danielvl1982/Dactyl-ZMK-Config/docs/preguntas-abiertas.md

# Preguntas abiertas

Points that cannot be confirmed from the code alone, and inconsistencies found while documenting. They stay marked as "inferred from code" in the rest of the documentation until answered. Global, stable numbering: items are never renumbered; resolved ones are struck through and kept.

## Negocio y datos

3. **Behavior with several layer keys held is not defined** (`config/dactyl.keymap:15-17`, `config/dactyl.keymap:44`, `config/dactyl.keymap:48`, `config/dactyl.keymap:50`, `config/dactyl.keymap:71`, `config/dactyl.keymap:84`). Holding two layer keys (for example SYM and NAV) activates both with the higher index winning; is that acceptable, or should a conditional layer or exclusive rule be defined? Impact: accidental double holds (pinky on SYM or NAV plus thumb on FN) can type characters from an unintended layer; for example SYM wins at the BT_SEL positions 31-33 when SYM and NAV are held, so profile select does nothing (BT_CLR still works).
4. **Rare ES AltGr symbols (euro and others) are not on SYM** (`docs/03-keymap.md:221-222`, `config/dactyl.keymap:77-88`). Should the euro sign and other AltGr symbols be added to SYM, and is a physical AltGr key needed? Impact: those characters cannot be typed from this keymap.
5. **BLE bond persistence is assumed from ZMK defaults** (`config/dactyl.keymap:71`, `config/dactyl.conf:1-15`, `build.yaml:6-8`). Confirm that bonds and the active profile survive power cycles and deep sleep on the nice!nano (no settings option is set in this repo). Impact: if settings are not persisted, the profile keys and the `settings_reset` image behave differently from what the docs describe.
6. **BT_CLR scope (central only) is not provable from this repo** (`config/dactyl.keymap:71`, `docs/03-keymap.md:140-141`). Does BT_CLR on the left (central) also clear the peripheral bond, or must `settings_reset` be flashed on the right half too? Impact: stale right-half bonds may remain after BT_CLR.
7. **Order to reset, re-flash and pair both halves with the host is undocumented** (`docs/operaciones.md:47`, `docs/04-roadmap.md:47-49`, `README.md:64-65`, `build.yaml:6-8`). In which order should `settings_reset` and the real firmware be flashed on each half, and must the host forget the keyboard before re-pairing? Owner to confirm after the first hardware run. Impact: a wrong order may leave stale bonds on a half or on the host and break pairing; the procedure is prose only and untested.
8. **Host view when the right half is asleep, off or out of range** (`config/dactyl.conf:3-6`, `config/dactyl.conf:11-12`). What level does the host show for the right half when it is disconnected or in deep sleep (stale value, zero, or entry removed)? Impact: the user may read an old level and not notice a drained right cell; no cut-off protects the cell.
9. **Origin of `holeD` 6.1 mm and `capH` 16 mm** (`hardware/switch-button/switch_cap.mjs:52`, `hardware/switch-button/switch_cap.mjs:55`, `hardware/switch-button/switch_cap.mjs:57`, `hardware/third-party/dactyl-4x6-trackball/pro_micro_adapter.stl`). `holeD` is marked MEASURED from `pro_micro_adapter.stl` and `capH` is marked MEASURE; who measured them and are they confirmed on a printed case? Does `stemH` 8.0 mm match the stated "1.9 wall + 4 out"? Impact: wrong values give a cap that does not pass through the hole or does not stand out of the case.

## Técnicas

10. **ZMK `revision: main` and CI `@main` are unpinned** (`config/west.yml:6-8`, `.github/workflows/build.yml:6`, `build.yaml:6-8`). Should the ZMK revision and the reusable workflow ref be pinned together to a tag or commit? Priority: low. Explanation for the owner: pinning fixes a version so builds are reproducible; without it any upstream change on ZMK `main` (including the `settings_reset` image and role/name defaults) can break or alter the firmware without a commit in this repo. Pinning to an old release may not compile because the shield uses the `nice_nano//zmk` board syntax; the minimum revision that supports it is unknown. User answer (user, docs-orchestrator session, October 2026): did not know the term and said "if it is a problem, fix it"; left OPEN, not decided. Impact: non-reproducible builds, silent breakage.
11. **Firmware v1.0 is not verified on hardware** (`docs/02-current-state.md:15`, `docs/02-current-state.md:55`, `docs/05-build-log.md:15`, `docs/05-build-log.md:20`, `docs/04-roadmap.md:24`, `docs/04-roadmap.md:41-50`, `docs/04-roadmap.md:57-58`, `config/boards/shields/dactyl/dactyl.dtsi:36-41`). Confirm on both flashed halves: the CI `.uf2` files work, the final 12-column transform and position table (F8), momentary SYM/NAV/NUM layers with `&trans` fall-through, NAV, BT_SEL 0..2 and BT_CLR including re-pairing, battery levels on the host (and on Windows with enforcement off), deep sleep and key wake with BLE reconnection, and the flash/reset/pair flow. Owner of the keyboard. Impact: a green build proves only that the firmware compiles; documented behavior is inferred from the keymap and ZMK semantics.
12. **ES host layout is assumed but cannot be enforced or detected** (`config/dactyl.keymap:8-10`, `config/dactyl.keymap:28`, `config/dactyl.keymap:34`, `config/dactyl.keymap:46`, `config/dactyl.keymap:50`, `config/dactyl.keymap:57`, `docs/03-keymap.md:3`, `docs/03-keymap.md:189-192`). Is ES (Windows KBDSP) the only supported host layout, including when switching Bluetooth profiles between machines (F7), or will X11 `es` or macOS layouts be used too? Impact: on a non-ES host, ñ, dead acute, hyphen, `{`, `}`, `[`, `]`, `\`, `<`, `>`, GRAVE (º) and the dead-key macros type different characters (for example the macros type "[ " and "{ ").
13. **Layer keys are on the peripheral half** (`config/dactyl.keymap:44`, `config/dactyl.keymap:48`, `config/dactyl.keymap:50`, `config/dactyl.conf:9-12`). What happens to layer state if the right half disconnects while a layer key is held (stuck layer)? Is it tested? Impact: a BLE drop mid-hold could leave a layer active or lose the release event.
14. **Consumer HID keys (volume, media) rely on a ZMK default** (`config/dactyl.keymap:71`, `config/dactyl.keymap:73`, `config/dactyl.conf:1-15`). Is the default consumer report enough on every target host (PC, laptop, phone)? Impact: volume and media keys may not work on a host that ignores consumer usages.
15. **PLAY replaces SPACE and letter keys are shadowed while NAV is held** (`config/dactyl.keymap:73`, `config/dactyl.keymap:50`). Is losing the space bar in NAV intended, given the board has no thumb cluster? Impact: media control and typing space cannot be combined in one hold.
16. **Last key of NUM row 1 is transparent and falls to the base-layer SYM key** (`config/dactyl.keymap:57`, `config/dactyl.keymap:44`). Is it intended that this position acts as `&mo LAYER_SYM` while FN is held, or should it be `&none`? Impact: holding FN and pressing that key activates SYM on top of NUM, which may be accidental.
17. **Physical Shift held on SYM changes plain-keycode symbols** (`config/dactyl.keymap:48`, `config/dactyl.keymap:80`, `config/dactyl.keymap:82`, `config/dactyl.keymap:84`). Should LSHFT be `&none` on SYM, or is shifted output (for example `<` becoming `>`) acceptable? Needs a flash test. Impact: holding Shift while typing symbols may yield a different character (inferred from code, unverified).
18. **Trackball (Logitech M575) is undecided and unsupported in code** (`README.md:19`, `docs/01-hardware.md:7`, `docs/04-roadmap.md:63`, `docs/04-roadmap.md:81`, `config/boards/shields/dactyl/dactyl_right.overlay:1-18`, `config/boards/shields/dactyl/dactyl.zmk.yml:8-9`). No sensor node, driver or ZMK pointing-device feature exists (roadmap says "Not started"), yet README and hardware docs describe a trackball on the right half. User context (user, docs-orchestrator session, October 2026): the owner has a Logitech M575 and has not decided whether to integrate it into the keyboard or keep it separate; integrating would need an extra board, or embedding the M575 board with its own power; the battery impact is unknown; the owner thinks there is enough space with small modifications. Which integration is intended (ZMK pointing device, embedded M575 board, or separate device), and should the docs say "planned/undecided"? Impact: the trackball cannot work with the current firmware; docs promise hardware the firmware does not drive.
19. **Upstream defaults of ZMK/Zephyr keys are assumed, not proven** (`config/dactyl.conf:3-6`, `config/dactyl.conf:10-12`, `config/dactyl.conf:14-15`, `config/west.yml:6-7`, `config/dactyl.keymap:71`). Confirm against the ZMK revision CI builds the defaults of `CONFIG_ZMK_SLEEP`, `CONFIG_ZMK_IDLE_SLEEP_TIMEOUT` (900000 ms and ms unit), `CONFIG_ZMK_BATTERY_REPORTING`, the two split battery fetching/proxy keys, `CONFIG_BT_GATT_ENFORCE_SUBSCRIPTION`, and the maximum BLE profile count (is the default at least 3, or should it be set explicitly?). Impact: the Default column of the keys table is inferred; if a default changes upstream, explicit values still win but the reason for each line cannot be checked, and a BT_SEL key would do nothing if the profile count were below 3.
20. **Peripheral role is implicit, relies on ZMK defaults** (`config/boards/shields/dactyl/Kconfig.defconfig:6-7`, `config/boards/shields/dactyl/Kconfig.defconfig:13-14`). Should the right half set an explicit peripheral option, or is relying on the ZMK default (split on, central off) intended? Impact: a ZMK change to the default could silently change the right-half role.
21. **Erase behavior of `settings_reset` is upstream and unverifiable here** (`build.yaml:6-8`). Does the ZMK `settings_reset` shield wipe the whole settings partition (bonds and profiles) at the unpinned `main` revision, as the comment states? Owner to confirm. Impact: if upstream changes the shield, the documented wipe may no longer hold.
22. **Artifact names, upload and retention of the CI build are defined upstream** (`.github/workflows/build.yml:6`, `README.md:59-61`, `docs/05-build-log.md:107-108`). What are the artifact names the reusable ZMK workflow produces, how long are they kept, so the right `.uf2` is copied to each half? Impact: risk of copying the wrong image; documented outputs rest on the build log, not on code in this repo.
23. **Central-only battery keys set in a conf shared with the peripheral** (`config/dactyl.conf:1`, `config/dactyl.conf:11-12`, `config/boards/shields/dactyl/Kconfig.defconfig:6-7`). Are the FETCHING and PROXY keys harmlessly ignored on the right half, or should they live in a left-only conf? Impact: an unused or unsupported symbol could cause a build warning or wasted code on the peripheral.
24. **Macro timing uses ZMK defaults and is not configured** (`config/dactyl.keymap:25-35`, `config/dactyl.conf`). Have the macros been tested on hardware and BLE hosts, or are `wait-ms`/`tap-ms` needed so the host registers the dead key before the space? Impact: on a slow host the space could arrive too early and the literal character might not compose.
25. **No automated tests; validation is compile plus manual typing** (`build.yaml:1-8`, `docs/04-roadmap.md:24`). Is flashing the CI artifacts and typing the only intended validation? CodeGraph indexes only `.mjs` files, so devicetree/Kconfig/keymap were read directly. Impact: regressions in the keymap or shield are found only on hardware.
26. **No deployment or release process** (`.github/workflows/build.yml:1-6`). Are releases or tagged artifacts wanted, or is manual download from workflow runs enough? Impact: firmware versions cannot be traced to a flashed board.
27. **Behavior of swapped or same-side firmware is not verified** (`config/boards/shields/dactyl/dactyl_right.overlay:15-18`, `config/boards/shields/dactyl/dactyl_left.overlay:3-13`). What happens if the left image is flashed on the right half or the reverse? Has it been tested? Impact: a wrong flash could give duplicated or missing columns; troubleshooting steps are unknown.
28. **Which half executes the `&bt` behavior when pressed on the right (peripheral) half** (`config/dactyl.keymap:71`, `config/boards/shields/dactyl/Kconfig.defconfig:6-7`, `docs/03-keymap.md:141-142`). Does BT_SEL/BT_CLR pressed on the right half act on the left central (as the docs claim) and change the host-facing profile? Needs confirmation on hardware. Impact: if the event were handled on the peripheral, profile switching would not affect the host connection.
29. **Generators have no validation and ignore their own fit checks** (`hardware/switch-button/switch_cap.mjs:135-150`, `hardware/switch-button/switch_cap.mjs:186-187`, `hardware/18650-holder/holder_18650_tight.mjs:40-84`, `hardware/18650-holder/holder_18650_tight.mjs:212-225`, `hardware/18650-holder/holder_18650_tight.mjs:264`). `switch_cap.mjs` prints FIT PROBLEMS but still overwrites the STL and exits 0; the holder generator has no parameter or non-manifold check at all. Should they skip the write or exit non-zero on problems (owner of the hardware decides)? Impact: a bad parameter set silently replaces the tracked STL with a part the script itself flagged, and `npm run build` still succeeds.
30. **`writeBinarySTL` is duplicated in both generators** (`hardware/18650-holder/holder_18650_tight.mjs:230-255`, `hardware/switch-button/switch_cap.mjs:155-180`). Extract a shared module, or keep the copies so each folder stays self-contained with its own `package.json`? Impact: a fix to normals or header in one writer must be applied twice.
31. **Committed STLs are not verified against the generators** (`hardware/18650-holder/holder_18650_tight.stl`, `hardware/18650-holder/holder_18650_tight_mirrored.stl`, `hardware/switch-button/switch_cap.stl`, `hardware/18650-holder/package.json:7`, `hardware/switch-button/package.json:7`). Are the STLs regenerated after every change to `P` (the last commit changed the end discs), and should a check or CI step enforce it? Deterministic output is inferred, not tested. Impact: STLs and parameters can drift apart; printed parts may not match the script described as the source of truth.
32. **Node engine version is not declared for the generators** (`hardware/18650-holder/package.json:1-13`, `hardware/switch-button/package.json:1-13`). Which Node version is required (ESM and top-level await)? Impact: generators may fail on older Node without a clear message.
33. **`seatDepth` does not control the real pocket depth in `terminalSeat`** (`hardware/18650-holder/holder_18650_tight.mjs:95-99`, `hardware/18650-holder/holder_18650_tight.mjs:111`, `hardware/18650-holder/holder_18650_tight.mjs:128-130`). The pocket extent into the wall is `xFace -/+ EPS` (EPS = 1.0), while `seatDepth` only affects the bore-side edge and `innerSpan`; is this slip intended? It works only because both equal 1.0. Impact: changing `seatDepth` alone makes `innerSpan` inconsistent with the cut pocket depth (inferred from code).
34. **Cradle side cut executed twice** (`hardware/18650-holder/holder_18650_tight.mjs:171`, `hardware/18650-holder/holder_18650_tight.mjs:194`). Is the second identical subtract (after the bore) intentional or a leftover? Impact: redundant boolean operation, no geometric effect (inferred from code).

## Seguridad

35. **GATT subscription enforcement is disabled to show battery on Windows** (`config/dactyl.conf:14-15`). Is disabling `CONFIG_BT_GATT_ENFORCE_SUBSCRIPTION` an accepted trade-off for all hosts, and does the battery display still require it with the ZMK revision used? Impact: weakens a BLE GATT check on every connection, not only on Windows, for a cosmetic battery display.

## Inconsistencias

36. **Holder generator header describes flush-trimmed end walls while `roundEnds` is true** (`hardware/18650-holder/holder_18650_tight.mjs:8-26`, `hardware/18650-holder/holder_18650_tight.mjs:61`, `hardware/18650-holder/holder_18650_tight.mjs:92`, `hardware/18650-holder/holder_18650_tight.mjs:166`). The header describes end walls flush with the rim and overall height 10.75 mm; with `roundEnds: true` the trim and ears are skipped and the end discs rise to `outerR` (11.45), so the overall height is about 22.2 mm (derived by hand). Which is the intended design, does it still fit the case, and should the header be rewritten? Impact: anyone trusting the header expects a low-profile holder; the printed part is taller at the end discs.
37. **`P.tabLen` is defined but never read** (`hardware/18650-holder/holder_18650_tight.mjs:76`). Remove `tabLen` or wire it into the tab channel/groove geometry? Impact: editing the value has no effect and misleads whoever tunes the holder.
38. **Ear parameters are dead while `roundEnds` is true** (`hardware/18650-holder/holder_18650_tight.mjs:66-69`, `hardware/18650-holder/holder_18650_tight.mjs:166-188`). Is the flat-end/ear variant still supported, or is `roundEnds` the only design to keep? Impact: `earAbovePlate`, `earSide`, `earChamfer` and the flush-trim branch are unreachable with the committed settings and may rot untested.
39. **Lead-in step corner wall is not checked** (`hardware/switch-button/switch_cap.mjs:112-115`, `hardware/switch-button/switch_cap.mjs:136`). Is a corner wall of about 0.66 mm at the lead-in mouth (default parameters) acceptable for printing? The 0.8 mm minimum is applied only to the socket. Impact: the thin rim could break or print poorly while the report says `fit : ok`.
40. **README and docs mention a TRRS cable, a trackball and an old file layout that the code does not contain** (`README.md:19`, `README.md:40-52`, `docs/01-hardware.md:12`). The README layout lists `dactyl_left.keymap` and `shields/dactyl_left`, but the repo has `dactyl.keymap` and `shields/dactyl`. Update the README? (Trackball part: see 18.) Impact: docs contradict the repository structure.
41. **README says builds run on pushes that change the config, but the workflow has no path filter** (`README.md:61`, `.github/workflows/build.yml:2`). Limit the workflow to config changes, or correct the README? Impact: docs-only pushes consume CI minutes and produce artifacts; the README is inaccurate.
42. **README says one half is flashed, current-state says both halves were** (`README.md:7`, `docs/02-current-state.md:21`, `docs/05-build-log.md:189`). Which is current: one half or both flashed with the test keymap? Impact: contradictory statement of the hardware verification baseline.
43. **Docs say 15 letters per hand but the right half has 12 letters** (`docs/03-keymap.md:56`, `config/dactyl.keymap:44-48`). Should the geometry line say 15 letters on the left and 12 on the right (plus ñ), or was a different count intended? Impact: documentation misstates the base layer layout.
44. **Layer indexes rely on node order with no check** (`config/dactyl.keymap:12`, `config/dactyl.keymap:15-17`, `config/dactyl.keymap:41`, `config/dactyl.keymap:54`, `config/dactyl.keymap:64`, `config/dactyl.keymap:77`). Should the `LAYER_*` constants be guarded (comment, CI check) or is the file order considered stable? Impact: reordering layer nodes silently remaps every `&mo` key.
45. **Stale legend comment on NAV row 3 omits the Bluetooth keys** (`config/dactyl.keymap:70`, `config/dactyl.keymap:71`). Should the comment list BT 0, BT 1, BT 2 and BT CLR as the bindings do? Impact: a reader believes the right half of row 3 is blank except DEL.
46. **END is bound on both the base layer and NAV while docs say it stays on base** (`config/dactyl.keymap:50`, `config/dactyl.keymap:67`, `docs/03-keymap.md:93`, `docs/05-build-log.md:134`). Is END on NAV intentional (grouped with HOME, PGUP, PGDN) or should it be `&trans`? Impact: redundant binding; docs describe only HOME moving to NAV.
47. **Docs say blank NUM cells are transparent but the outer-bottom keys are `&none`** (`docs/03-keymap.md:121`, `config/dactyl.keymap:60`). Should the doc mention the `&none` positions, or should they be `&trans`? Impact: cells look identical in the diagram but behave differently (`&none` blocks fall-through).
48. **Docs say the right pinky and outer columns are unavailable under SYM, but they are `&trans`** (`docs/03-keymap.md:146-148`, `config/dactyl.keymap:80-86`, `config/dactyl.keymap:46`, `config/dactyl.keymap:50`). Is the fall-through to base (ñ, dead acute, ENTER, BSPC, MO(NUM), MO(NAV)) intended while SYM is held, or should those positions be `&none`? Impact: documentation misstates which keys work under SYM.
49. ~~**Wrong line cited for `CONFIG_ZMK_BATTERY_REPORTING` in operaciones.md**~~ Resuelto (October 2026): the citation in `docs/operaciones.md:67` was corrected from `config/dactyl.conf:9` to `config/dactyl.conf:10`, the line that holds the key (verified in `docs/operaciones.md:67` and `config/dactyl.conf:10`).
50. **Docs say "No macros" for accents while two dead-key macros exist** (`docs/03-keymap.md:19-20`, `docs/03-keymap.md:216-217`, `config/dactyl.keymap:25-35`). Should the accents note say only acute and diaeresis are native dead keys, and grave and caret use macros? Impact: documentation contradicts the keymap.
51. **Docs list dead grave as `&kp LBKT` but SYM binds `macro_grave`** (`docs/03-keymap.md:36`, `docs/03-keymap.md:197`, `config/dactyl.keymap:80`). Is there intentionally no plain dead grave key on any layer? Impact: grave-accented vowels (à, è, ò) cannot be typed because the macro always appends a space.
52. **`docs/02-current-state.md` describes a transform diagnosis that no longer matches the overlays** (`docs/02-current-state.md:40-50`, `config/boards/shields/dactyl/dactyl_left.overlay:3-13`, `config/boards/shields/dactyl/dactyl.dtsi:32-42`). Should it say the mirror fix is already applied in the shared transform (reversed right columns plus col-offset)? Impact: the doc says the fix is pending; the overlay now holds no transform.
53. **Keyboard name is defined twice** (`config/boards/shields/dactyl/Kconfig.defconfig:4`, `config/boards/shields/dactyl/dactyl.zmk.yml:3`). Is the metadata `name` only a UI label, and should both be kept in sync by hand? Impact: renaming in one place leaves the other stale; the BLE name comes only from the Kconfig value.

## Resuelto durante la documentación

1. ~~**Matrix transform maps 24 positions per half but each half has 23 keys**~~ Resuelto (October 2026): 23 physical keys per half is correct; the 24th transform position (RC(3,0) / RC(3,6), positions 36 and 47) is intentionally kept and bound to `&none`, so the keymap stays a regular 4x12 grid (user, docs-orchestrator session). Evidence: `config/boards/shields/dactyl/dactyl.dtsi:29-31`, `config/boards/shields/dactyl/dactyl.dtsi:37-40`, `config/dactyl.keymap:50`, `README.md:16`. Follow-up: README/docs wording is correct, no code change; the .dtsi comment may optionally say the position is kept on purpose.
2. ~~**Idle sleep timeout was set in the working tree but the committed file said default**~~ Resuelto (October 2026): the owner decided 5 minutes (the only cost of a shorter timeout versus 15 min is a slightly slower first keypress after wake) (user, docs-orchestrator session). `config/dactyl.conf:3-6` sets `CONFIG_ZMK_IDLE_SLEEP_TIMEOUT=300000`, committed in 8ac7234 (`feat(firmware): set deep sleep idle timeout to 5 minutes`, on main). Follow-up: `sueno-profundo`, `configuracion` and `operaciones` already say 5 min.
