danielvl1982/Dactyl-ZMK-Config/hardware/18650-holder/holder_18650_tight.stl

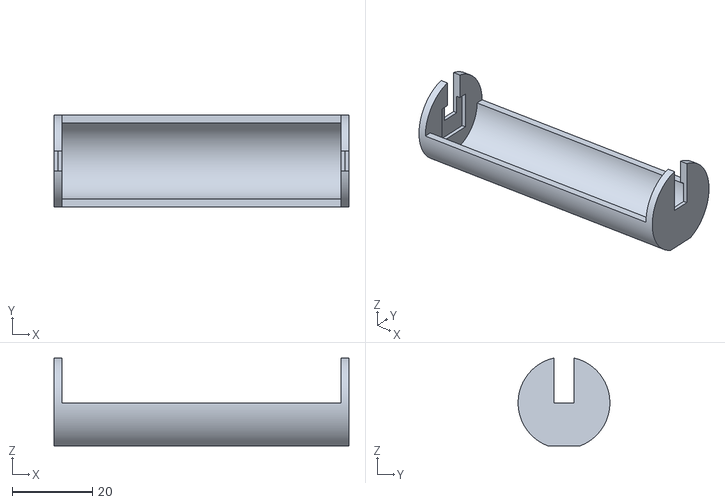
[picture p1: CAD file, 2026-10-27]
hardware/18650-holder/holder_18650_tight.stl
73.6 x 22.9 x 21.9
