danielvl1982/Dactyl-ZMK-Config/hardware/switch-button/switch_cap.stl

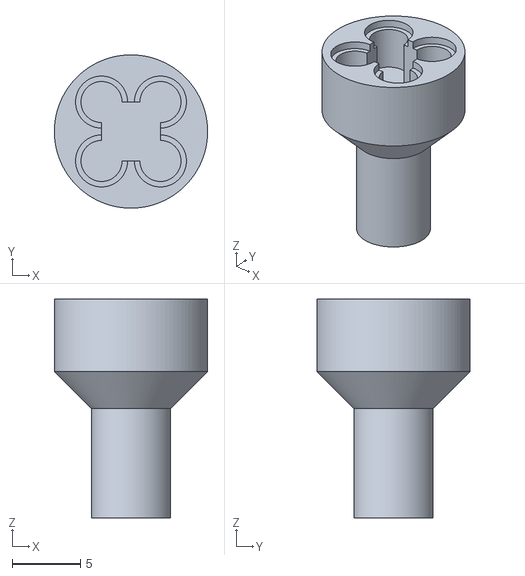
[picture p2: CAD file, 2026-10-27]
hardware/switch-button/switch_cap.stl
11.2 x 11.2 x 16.0
