danielvl1982/Dactyl-ZMK-Config/(list of files, cad)

Other CAD files:
hardware/18650-holder/holder_18650_tight_mirrored.stl
