danielvl1982/Dactyl-ZMK-Config/docs/05-build-log.md

# Build log

Newest entries first. Every entry records what was done, what was observed and what
comes next. Failures are recorded with their cause and their fix.

## 2026-10-26 — Firmware power and Bluetooth settings built

**Done**

- Added `config/dactyl.conf` with deep sleep and split battery reporting, and the
  `&bt` profile keys on `NAV` (commit `2bdfcf7`).

**Observed**

- GitHub Actions build on `2bdfcf7` finished green and produced both `.uf2` files.
- Nothing has been flashed yet, so none of this is verified on hardware.

**Pending**

- Flash both halves and `settings_reset`, pair over BLE, verify every key and layer.
- Fit the 18650 cells with cut-off switches and measure battery life.
- Open items in Phase 1, 4 and 5 of the [roadmap](04-roadmap.md): AliExpress
  descriptions, board check, layer and accent tests, trackball decision, labels.

## 2026-10-26 — Holder redesign and switch cap

**Done**

- Holder: end walls trimmed flush with the cradle rim (cradle 10.75 mm), retaining
  ears over each end wall (overall 17.75 mm), tab channel as wide as the plate seat
  (9.4 / 10.4 mm), wire slot opened to 5.0 mm wide and 4.0 mm deep, about 6.4 g.
- Tried a centered half ring so the cell would snap in. It broke the first time the
  cell was inserted, so it was removed.
- Added the parametric switch cap generator in `hardware/switch-button/`.
- Battery decision: six cells go to three Dactyl builds; the 4S board is retired.

**Observed**

- Generated meshes report `NoError`. The new holder and the switch cap have not been
  printed or fitted yet.

**Pending**

- Print and test both parts, then close the cell with tape or heat shrink.

## 2026-10-23 — Custom 18650 battery holder

> Superseded on 2026-10-26: the dimensions and the tab channel below changed.

**Done**

- Measured the stock tray `NCR18650B/1_Batterie_2.0.stl` and replaced it with a
  parametric holder generated from Node and `manifold-3d`: half-cylinder cradle,
  2 mm walls, 18.9 mm bore, 73.6 x 22.9 x 20.0 mm, about 7 g of PLA.
- Sized both end walls around the real solder-tab terminals: a 9.4 mm square pocket
  for the 9 x 9 mm spring plate and a 10.4 mm one for the 10 x 10 mm dome plate,
  1.0 mm deep, plus a 4.4 mm tab channel that exits through the top face of each
  wall.
- Cut the cradle at the cell axis so the cell drops in without flexing the plastic,
  and closed each end wall to 2.0 mm to shorten the part by 4 mm.
- Documented the design in [01-hardware.md](01-hardware.md#battery-holder-18650).
- Versioned the design under `hardware/18650-holder/`: the generator as the source
  of truth, both STLs, and a `package.json` that pins `manifold-3d`. `node_modules/`
  is ignored.

**Observed**

- Both STLs are closed and consistently oriented: 1620 triangles, 0 unmatched or
  duplicated directed edges, 5629 mm3, bounding box 0,-11.45,0 to 73.60,11.45,20.00.
- Ray probes confirm every critical dimension: 18.90 mm bore, 2.00 mm walls, the two
  square seats at 9.40 and 10.40 mm, 4.40 mm channels, 1.00 mm of wall behind each
  seat and a 10.75 mm tall cradle against a 20.00 mm end wall.
- The first design, with a conical spring pocket and a closed cradle, was discarded
  once the terminals were identified: they are plates, not round contacts.

**Not done yet**

- Nothing from this version has been printed yet.
- The spring free height is still unmeasured, so the 3.5 mm installed height and
  therefore the 73.6 mm length are assumptions. Shortening the holder further means
  compressing the spring closer to its solid height.

**Next**

- Print the holder, check the terminal and cell fit, and close the cell with heat
  shrink before wiring it to the nice!nano.

## 2026-10-21 — Split firmware and keymap v1.0

**Done**

- Rebuilt the shield as one directory, `config/boards/shields/dactyl/`, shared by
  both halves: `dactyl.dtsi` holds the kscan and a 12-column transform, with
  `dactyl_left.overlay` and `dactyl_right.overlay` adding the column pins.
- Added the split: `ZMK_SPLIT` on both halves, `ZMK_SPLIT_ROLE_CENTRAL` on the left,
  and `col-offset = <6>` on the right so its reversed columns land in reading order.
- Implemented `config/dactyl.keymap` with the four v1.0 layers, 48 bindings each:
  the 46 keys plus the two `&none` gaps where there is no switch.
- Translated every ES symbol to its AltGr combination (`&kp RA(...)`); backtick and
  circumflex became macros because both are dead keys on ES.
- Added both shields to `build.yaml`. The keymap moved from
  `config/dactyl_left.keymap` to `config/dactyl.keymap`, which applies to both.

**Observed**

- CI run `39615755235` succeeded and produced `dactyl_left-nice_nano__zmk-zmk.uf2`
  (460800 bytes) and `dactyl_right-nice_nano__zmk-zmk.uf2` (377856 bytes).
- An independent review of the ES bindings found nine wrong ones: braces, brackets,
  backslash and angle brackets were mapped from the X11 `es` layout, which differs
  from the Windows layout the keyboard talks to. They were corrected against
  KBDSP and CI run `39643551800` succeeded on the corrected keymap.
- Not flashed. The build proves it compiles, not that every key is in the right place.

**Next**

- Flash both halves and run the per-key check described in
  [02-current-state.md](02-current-state.md).

---

## 2026-10-21 — Keymap v1.0 supersedes v0.2

**Done**

- Reconciled the divergence between the two working machines. The keymap drafted
  locally as v1.0 was kept as the definitive design and v0.2 stayed in the history.
- Restored [03-keymap.md](03-keymap.md) to v1.0: three held layers, `NUM`, `NAV`
  and `SYM`, using `&trans` so the base modifiers and letters stay available while
  a layer is held.
- Decided the three free outer-right keys: `MO(SYM)` on row 1, the dead acute `´`
  on row 2, `MO(NAV)` on row 3, all held by the right pinky.
- Decided the bottom row: `SPACE` on the left `index2`, `LCTRL` and `LGUI` next to
  it, `LALT` on the right bottom row, `HOME` moved to `NAV`, `END` kept on base.
- Updated the open-decisions table in [04-roadmap.md](04-roadmap.md) to v1.0.

**Observed**

- This is a documented layout decision only. The v1.0 keymap has not been
  implemented in devicetree, flashed or tested on the keyboard.
- v1.0 supersedes v0.2 because `&none` on the function maps of v0.2 disabled the
  modifiers while a layer was held.

**Next**

- Implement the ES symbol bindings, the held-layer behavior and the bottom-row
  trades during Phase 4 of the roadmap.

---

## 2026-10-21 — Keymap v0.2 approved

**Done**

- Documented the approved 46-key NORMAL map in [03-keymap.md](03-keymap.md):
  QWERTY letters, a left Shift in the position initially called Caps, direct
  Home/End, and an Enter/Space/Backspace cluster on the lower right.
- Defined two held function maps: `FN1` for the Spanish number row and F1-F12,
  and `FN2` for navigation and coding symbols, especially `<`, `>`, and `@`.
- Kept the maps independent: positions not assigned on a function map are
  inactive rather than falling through to NORMAL.

**Observed**

- This is a documented layout decision only. The v0.2 keymap has not been
  implemented in devicetree, flashed or tested on the keyboard.

**Next**

- Implement and validate the ES symbol bindings, held-layer behavior, and
  modifier access on function maps during Phase 4 of the roadmap.

---

## 2026-10-20 — Project documentation

**Done**

- Created `README.md` and the `docs/` folder in the `Dactyl-ZMK-Config` repository.
- Wrote the hardware reference, current state, keymap v0.1, roadmap and this log.
- Agreed the design direction for the keymap:
  - Spanish (ES) host layout with `Ñ`.
  - QWERTY letter positions, as a Spanish keyboard has them.
  - Numbers on a `NUM` layer to free the top row.
  - Accents through the native ES dead keys, no macros.

**Observed**

- Both halves were flashed with the test keymap `A`..`X` and every switch registers.
- The left half types `abcdef / ghijkl / mnopqr / tuvwx`.
- The right half types `fedcba / lkjihg / rqponm / xwvut`.
- The fourth row has five keys, so there are **23 keys per half**, not 24.

**Cause of the mirror**

- The right PCB is a physical mirror of the left, so its column 0 is the outer key
  instead of the inner one.
- The current shield maps the matrix straight through with no per-half handling, so
  the right half reads each row backwards.
- This is a transform issue, not a keymap issue.

**Not done yet**

- The right shield, the split configuration and the real keymap.
- Batteries and BLE operation.

**Next**

- Build the `dactyl_right` shield and the split configuration (Phase 2 of the
  roadmap).

---

## Earlier history (pre-repository)

- Case and keycaps printed from the Thingiverse models in `files/`.
- Matrix hand-wired, 4 rows x 6 columns per half, col2row diodes.
- Both halves flashed with a 24-position test keymap (`A`..`X`) to verify the wiring.
- Vendor firmware (`CURRENT.UF2`) kept as a reference in the parent project folder.
