danielvl1982/Dactyl-ZMK-Config/(commit log)

2026-10-21 fix: correct ES AltGr bindings for brackets, braces, backslash and angle brackets
2026-10-23 docs: document the custom 18650 battery holder
2026-10-25 feat(hardware): add glue key slot to 18650 holder terminal seats
    Narrow vertical slot (1.5 x 0.6 mm) in each seat floor so the plate does not shift while the glue cures. End walls stay flush with the cradle rim. Ear and chamfer options remain in the generator, disabled by default (earAbovePlate: 0).
2026-10-26 feat(hardware): add retaining ears with wire slot to 18650 holder
    Enable terminal-tab retaining ears and replace the seat floor key slot
    with a central wire slot through each ear.
2026-10-26 feat(firmware): add deep sleep, split battery reporting and BT profile keys
2026-10-26 docs: record pending tasks and current firmware build state
2026-10-26 feat(hardware): widen 18650 terminal channels and wire slot, drop retaining ring
2026-10-26 feat(hardware): add parametric switch button cap generator
2026-10-26 docs(hardware): update battery holder and document the switch cap
2026-10-26 docs: sync roadmap, current state and build log with the holder and switch cap
2026-10-27 docs(hardware): add third-party STL parts with original attribution and licenses
2026-10-27 fix(hardware): ship the hot-swap case STLs instead of nonHS
2026-10-27 feat(hardware): add stem to switch cap sized for the TRRS hole
2026-11-07 feat(firmware): add BLE variants of the solo halves for wireless bring-up
2026-11-07 fix(firmware): shorten solo keyboard names to fit the BLE device name limit
